nguyentrungg/dattalogger/pcb/data_logger/data_logger.xlsx

Comment | Designator | Footprint | Quantity
DS1307 | *1 | SOIC 8 | 1 | 4000 | 4000 | http://linhkienchatluong.vn/ic-real-time-thoi-gian-thuc/ds1307-real-time-clock-sop-8-loai-thuong_sp656_ct1438.aspx
STM32F030C8T6 | *2, *5 | STM32_LQPF48 | 2 | 69000 | 138000 | http://linhkienchatluong.vn/stm/stm32f030c8t6-lqfp48-chinh-hang-st_sp564_ct7588.aspx
CH340G | *4 | CH340G | 1 | 11000 | 11000 | http://linhkienchatluong.vn/ic-giao-tiep--mang/ch340g-sop-16-chinh-hang-wch_sp575_ct423.aspx
MC1403 | *6, *8 | dip8 | 2 | 6000 | 12000 | http://linhkienchatluong.vn/cac-loai-khac/mc1403-dip-8-low-voltage-reference_sp581_ct699.aspx
LMV321 | *7, *9 | SOT23-5 | 2 | 3800 | 7600 | http://linhkienchatluong.vn/ic-opam/lmv321-rc1f-sot23-5-chinh-hang-ti_sp574_ct14374.aspx
ADG708 | ADG1, ADG2, ADG3, ADG4 | TSSOP16 | 4 | 35000 | 140000 | https://linhkien.cxt.vn/5587-adg708bruz-reel7-ic-multiplexer-8x1-16tssop.html
AMS1117-3.3V | AMS1 | SOT223 | 1 | 1500 | 1500 | http://linhkienchatluong.vn/ho-ams--1117/ams1117-33v-ic-on-ap-33v-1a-sot-223_sp1008_ct371.aspx
CR1220 SMD | BT1 | DE PIN CR1220 | 1 | 2500 | 2500 | http://linhkienchatluong.vn/de-pin---mu-pin/de-pin-cr1220-chan-dan-smd_sp541_ct1533.aspx
104 | C1, C2, C18, C19, C31 | tu 0603 | 1 | 2000 | 2000 | http://linhkienchatluong.vn/tu-dan-0603/tu-dan-0603-du-gia-tri-tu-1pf-den-22uf-10c_sp1063_ct7503.aspx
1nF | C29 | tu 0603 | 1 | 2000 | 2000 | http://linhkienchatluong.vn/tu-dan-0603/tu-dan-0603-102-1nf-0001uf-50v-10c_sp1063_ct14592.aspx
Header 2P 2.54 Duc Thang | H1, H2, H3, H4, H5, H6, H7, H8 | 15EDGR-3.81-2P | 8 | 2000 | 16000 | http://linhkienchatluong.vn/cau-dau-15edg381-xanh/cau-dau-2p-15edg381-2p-381mm-xanh-cong_sp1021_ct7328.aspx
Nut Nhan 4 Chan Cam 6x6 | ok1, ok2, ok3, ok4, ok5, ok6, ok7, ok8 | Nut Nhan 4 Chan Cam 6x6 | 1 | 6000 | 6000 | http://linhkienchatluong.vn/nut-nhan-6x6-4p-dip/nut-nhan-4-chan-6x6x16mm-tiep-diem-dong-dip-10c_sp851_ct1815.aspx
Micro SD card | P1 | MicroSD | 1 | 2000 | 2000 | http://linhkienchatluong.vn/khe-the-nho-khe-sim/khe-cam-the-nho-tf-microsd-9p-nhan-nha-thao-the-socket-the-nho_sp732_ct2318.aspx
100k | R29, R43, R45, R46, R57, R60, R62, R63 | tro smd 0603 | 1 | 2000 | 2000 | http://linhkienchatluong.vn/dien-tro-dan-0603-116w/dien-tro-dan-0603-100k-1-50c_sp836_ct5811.aspx
12k | R30, R49 | tro smd 0603 | 1 | 2000 | 2000 | http://linhkienchatluong.vn/dien-tro-dan-0603-116w/dien-tro-dan-0603-12k-1-50c_sp836_ct5793.aspx
24k | R33, R44, R51, R61 | tro smd 0603 | 1 | 2000 | 2000 | http://linhkienchatluong.vn/dien-tro-dan-0603-116w/dien-tro-dan-0603-24k-1-50c_sp836_ct8434.aspx
47k | R36, R53 | tro smd 0603 | 1 | 2000 | 2000 | http://linhkienchatluong.vn/dien-tro-dan-0603-116w/dien-tro-dan-0603-47k-1-50c_sp836_ct8437.aspx
3k | R37, R54 | tro smd 0603 | 1 | 2000 | 2000 | http://linhkienchatluong.vn/dien-tro-dan-0603-116w/dien-tro-dan-0603-3k-1-50c_sp836_ct11748.aspx
62k | R39, R55, R67, R83 | tro smd 0603 | 1 | 2000 | 2000 | http://linhkienchatluong.vn/dien-tro-dan-0603-116w/dien-tro-dan-0603-62k-1-50c_sp836_ct8438.aspx
82k | R41, R58 | tro smd 0603 | 1 | 2000 | 2000 | http://linhkienchatluong.vn/dien-tro-dan-0603-116w/dien-tro-dan-0603-82k-1-50c_sp836_ct8441.aspx
18k | R42, R59, R68, R84 | tro smd 0603 | 1 | 2000 | 2000 | http://linhkienchatluong.vn/dien-tro-dan-0603-116w/dien-tro-dan-0603-18k-1-50c_sp836_ct5795.aspx
240k | R47, R64 | tro smd 0603 | 1 | 2000 | 2000 | http://linhkienchatluong.vn/dien-tro-dan-0603-116w/dien-tro-dan-0603-240k-1-50c_sp836_ct14368.aspx
160k | R66, R81 | tro smd 0603 | 1 | 3000 | 3000 | http://linhkienchatluong.vn/dien-tro-dan-0805-18w/dien-tro-dan-0805-160k-1-50c_sp837_ct5399.aspx
30k | R69, R71, R87, R89 | tro smd 0603 | 1 | 2000 | 2000 | http://linhkienchatluong.vn/dien-tro-dan-0603-116w/dien-tro-dan-0603-30k-1-50c_sp836_ct5800.aspx
2k | R72, R90 | tro smd 0603 | 1 | 2000 | 2000 | http://linhkienchatluong.vn/dien-tro-dan-0603-116w/dien-tro-dan-0603-2k-1-50c_sp836_ct8910.aspx
20k | R74, R77, R86, R91 | tro smd 0603 | 1 | 2000 | 2000 | http://linhkienchatluong.vn/dien-tro-dan-0603-116w/dien-tro-dan-0603-20k-1-50c_sp836_ct8433.aspx
16k | R75, R93 | tro smd 0603 | 1 | 2000 | 2000 | http://linhkienchatluong.vn/dien-tro-dan-0805-18w/dien-tro-dan-0805-16k-1-50c_sp837_ct5375.aspx
3.3k | R79, R96 | tro smd 0603 | 1 | 2000 | 2000 | http://linhkienchatluong.vn/dien-tro-dan-0603-116w/dien-tro-dan-0603-33k-1-50c_sp836_ct8427.aspx
5.1k | R97 | tro smd 0805 | 1 | 2000 | 2000 | http://linhkienchatluong.vn/dien-tro-dan-0603-116w/dien-tro-dan-0603-51k-1-50c_sp836_ct5785.aspx
74HC245 SMD | U1 | SOP 20 | 1 | 4200 | 4200 | http://linhkienchatluong.vn/ic-ho-74---ic-logic/74hc245d-sop-20-72mm-chinh-hang-nxp_sp550_ct345.aspx
100R | VR1 | Bien Tro Tam Giac Dung | 1 | 1000 | 1000 | http://linhkienchatluong.vn/bien-tro-tam-giac-rm065/bien-tro-tam-giac-rm065-101-100r-_sp594_ct2005.aspx
8Mhz | X1, X2 | XTAL_SMD_3P5 | 2 | 5000 | 10000 | http://linhkienchatluong.vn/cac-loai-thach-anh-khac/thach-anh-8mhz-5032-5x32mm-smd-2p_sp615_ct1170.aspx
32.767kHz | Y1 | Thach Anh 2 Chan 32,768 KHz | 1 | 1500 | 1500 | http://linhkienchatluong.vn/thach-anh-ong/thach-anh-ong-32768khz-2x6mm_sp613_ct1853.aspx
12Mhz | Y2 | Thach Anh 2 chan cam | 1 | 2000 | 2000 | http://linhkienchatluong.vn/thach-anh-chan-cam-hc-49s/thach-anh-12mhz-hc-49s_sp610_ct1072.aspx
 |  |  | 48 |  | 396300
0.01uF |  |  |  |  |  | http://linhkienchatluong.vn/tu-dan-0603/tu-dan-0603-du-gia-tri-tu-1pf-den-22uf-10c_sp1063_ct7503.aspx
22pF |  |  |  |  |  | http://linhkienchatluong.vn/tu-dan-0603/tu-dan-0603-du-gia-tri-tu-1pf-den-22uf-10c_sp1063_ct7503.aspx
