nguyentrungg/dattalogger/(list of files, cad)

Other CAD files:
box/Untitled.skp
