nguyentrungg/dattalogger/(list of files, drawings)

Other design files:
pcb/data_logger/8_channels.SchDoc
pcb/data_logger/channel_1.SchDoc
pcb/data_logger/channel_2.SchDoc
pcb/data_logger/channel_3.SchDoc
pcb/data_logger/channel_45678.SchDoc
pcb/data_logger/data_logger.PrjPcb
pcb/data_logger/data_logger.SchDoc
pcb/data_logger/mcu.SchDoc
pcb/data_logger/pga.SchDoc
pcb/data_logger/power_supply.SchDoc
pcb/data_logger/real_time_clock.SchDoc
pcb/data_logger/sd_card.SchDoc
pcb/data_logger/uart_to_usb.SchDoc
proteus/a.pdsprj
proteus/b.pdsprj
proteus/Project Backups/a [20220628, 17-11-29].pdsprj
proteus/Project Backups/a [20220628, 22-40-48].pdsprj
proteus/Project Backups/a [20220628, 23-52-18].pdsprj
proteus/Project Backups/a [20220809, 16-01-18].pdsprj
proteus/Project Backups/a [20220809, 16-05-03].pdsprj
proteus/Project Backups/a [20220809, 16-07-31].pdsprj
proteus/Project Backups/a [20220809, 16-24-51].pdsprj
proteus/Project Backups/a [20220809, 16-30-40].pdsprj
proteus/Project Backups/a [20220809, 16-31-18].pdsprj
proteus/Project Backups/a [20220809, 16-43-23].pdsprj
